falcaodiogo/PIOT-SoSe26/(commit log)

2026-06-17 Add MQTT connection and DHT sensor functionality to Arduino scripts
2026-06-26 Connection to all sensors to frontend
2026-06-29 ai meu deus já nem sei o que é que isto vai dar
2026-07-07 Prototype presentation on-site
